amiltonkoxi/FMEAD-FPGA/vitis_platform/mb_edge_wrapper/microblaze_0/standalone_microblaze_0/bsp/microblaze_0/include/xparameters.h

#ifndef XPARAMETERS_H   /* prevent circular inclusions */
#define XPARAMETERS_H   /* by using protection macros */

/* Definitions for bus frequencies */
#define XPAR_CPU_M_AXI_DP_FREQ_HZ 100000000
/******************************************************************/

/* Canonical definitions for bus frequencies */
/******************************************************************/

#define XPAR_CPU_CORE_CLOCK_FREQ_HZ 100000000
#define XPAR_MICROBLAZE_CORE_CLOCK_FREQ_HZ 100000000

/******************************************************************/


/* Definitions for peripheral MICROBLAZE_0 */
#define XPAR_MICROBLAZE_0_ADDR_SIZE 32
#define XPAR_MICROBLAZE_0_ADDR_TAG_BITS 17
#define XPAR_MICROBLAZE_0_ALLOW_DCACHE_WR 1
#define XPAR_MICROBLAZE_0_ALLOW_ICACHE_WR 1
#define XPAR_MICROBLAZE_0_AREA_OPTIMIZED 0
#define XPAR_MICROBLAZE_0_ASYNC_INTERRUPT 1
#define XPAR_MICROBLAZE_0_ASYNC_WAKEUP 3
#define XPAR_MICROBLAZE_0_AVOID_PRIMITIVES 0
#define XPAR_MICROBLAZE_0_BASE_VECTORS 0x0000000000000000
#define XPAR_MICROBLAZE_0_BRANCH_TARGET_CACHE_SIZE 0
#define XPAR_MICROBLAZE_0_CACHE_BYTE_SIZE 8192
#define XPAR_MICROBLAZE_0_DADDR_SIZE 32
#define XPAR_MICROBLAZE_0_DATA_SIZE 32
#define XPAR_MICROBLAZE_0_DCACHE_ADDR_TAG 17
#define XPAR_MICROBLAZE_0_DCACHE_ALWAYS_USED 1
#define XPAR_MICROBLAZE_0_DCACHE_BASEADDR 0x00000000
#define XPAR_MICROBLAZE_0_DCACHE_BYTE_SIZE 8192
#define XPAR_MICROBLAZE_0_DCACHE_DATA_WIDTH 0
#define XPAR_MICROBLAZE_0_DCACHE_FORCE_TAG_LUTRAM 0
#define XPAR_MICROBLAZE_0_DCACHE_HIGHADDR 0x3FFFFFFF
#define XPAR_MICROBLAZE_0_DCACHE_LINE_LEN 4
#define XPAR_MICROBLAZE_0_DCACHE_USE_WRITEBACK 0
#define XPAR_MICROBLAZE_0_DCACHE_VICTIMS 0
#define XPAR_MICROBLAZE_0_DC_AXI_MON 0
#define XPAR_MICROBLAZE_0_DEBUG_COUNTER_WIDTH 32
#define XPAR_MICROBLAZE_0_DEBUG_ENABLED 1
#define XPAR_MICROBLAZE_0_DEBUG_EVENT_COUNTERS 5
#define XPAR_MICROBLAZE_0_DEBUG_EXTERNAL_TRACE 0
#define XPAR_MICROBLAZE_0_DEBUG_INTERFACE 0
#define XPAR_MICROBLAZE_0_DEBUG_LATENCY_COUNTERS 1
#define XPAR_MICROBLAZE_0_DEBUG_PROFILE_SIZE 0
#define XPAR_MICROBLAZE_0_DEBUG_TRACE_ASYNC_RESET 0
#define XPAR_MICROBLAZE_0_DEBUG_TRACE_SIZE 8192
#define XPAR_MICROBLAZE_0_DIV_ZERO_EXCEPTION 0
#define XPAR_MICROBLAZE_0_DP_AXI_MON 0
#define XPAR_MICROBLAZE_0_DYNAMIC_BUS_SIZING 0
#define XPAR_MICROBLAZE_0_D_AXI 1
#define XPAR_MICROBLAZE_0_D_LMB 1
#define XPAR_MICROBLAZE_0_D_LMB_MON 0
#define XPAR_MICROBLAZE_0_D_LMB_PROTOCOL 0
#define XPAR_MICROBLAZE_0_ECC_USE_CE_EXCEPTION 0
#define XPAR_MICROBLAZE_0_EDGE_IS_POSITIVE 1
#define XPAR_MICROBLAZE_0_ENABLE_DISCRETE_PORTS 0
#define XPAR_MICROBLAZE_0_ENDIANNESS 1
#define XPAR_MICROBLAZE_0_FAULT_TOLERANT 0
#define XPAR_MICROBLAZE_0_FPU_EXCEPTION 0
#define XPAR_MICROBLAZE_0_FREQ 100000000
#define XPAR_MICROBLAZE_0_FSL_EXCEPTION 0
#define XPAR_MICROBLAZE_0_FSL_LINKS 0
#define XPAR_MICROBLAZE_0_IADDR_SIZE 32
#define XPAR_MICROBLAZE_0_ICACHE_ALWAYS_USED 1
#define XPAR_MICROBLAZE_0_ICACHE_BASEADDR 0x00000000
#define XPAR_MICROBLAZE_0_ICACHE_DATA_WIDTH 0
#define XPAR_MICROBLAZE_0_ICACHE_FORCE_TAG_LUTRAM 0
#define XPAR_MICROBLAZE_0_ICACHE_HIGHADDR 0x3FFFFFFF
#define XPAR_MICROBLAZE_0_ICACHE_LINE_LEN 4
#define XPAR_MICROBLAZE_0_ICACHE_STREAMS 0
#define XPAR_MICROBLAZE_0_ICACHE_VICTIMS 0
#define XPAR_MICROBLAZE_0_IC_AXI_MON 0
#define XPAR_MICROBLAZE_0_ILL_OPCODE_EXCEPTION 0
#define XPAR_MICROBLAZE_0_IMPRECISE_EXCEPTIONS 0
#define XPAR_MICROBLAZE_0_INSTR_SIZE 32
#define XPAR_MICROBLAZE_0_INTERCONNECT 2
#define XPAR_MICROBLAZE_0_INTERRUPT_IS_EDGE 0
#define XPAR_MICROBLAZE_0_INTERRUPT_MON 0
#define XPAR_MICROBLAZE_0_IP_AXI_MON 0
#define XPAR_MICROBLAZE_0_I_AXI 0
#define XPAR_MICROBLAZE_0_I_LMB 1
#define XPAR_MICROBLAZE_0_I_LMB_MON 0
#define XPAR_MICROBLAZE_0_I_LMB_PROTOCOL 0
#define XPAR_MICROBLAZE_0_LMB_DATA_SIZE 32
#define XPAR_MICROBLAZE_0_LOCKSTEP_MASTER 0
#define XPAR_MICROBLAZE_0_LOCKSTEP_SELECT 0
#define XPAR_MICROBLAZE_0_LOCKSTEP_SLAVE 0
#define XPAR_MICROBLAZE_0_M0_AXIS_DATA_WIDTH 32
#define XPAR_MICROBLAZE_0_M0_AXIS_PROTOCOL GENERIC
#define XPAR_MICROBLAZE_0_M1_AXIS_DATA_WIDTH 32
#define XPAR_MICROBLAZE_0_M1_AXIS_PROTOCOL GENERIC
#define XPAR_MICROBLAZE_0_M2_AXIS_DATA_WIDTH 32
#define XPAR_MICROBLAZE_0_M2_AXIS_PROTOCOL GENERIC
#define XPAR_MICROBLAZE_0_M3_AXIS_DATA_WIDTH 32
#define XPAR_MICROBLAZE_0_M3_AXIS_PROTOCOL GENERIC
#define XPAR_MICROBLAZE_0_M4_AXIS_DATA_WIDTH 32
#define XPAR_MICROBLAZE_0_M4_AXIS_PROTOCOL GENERIC
#define XPAR_MICROBLAZE_0_M5_AXIS_DATA_WIDTH 32
#define XPAR_MICROBLAZE_0_M5_AXIS_PROTOCOL GENERIC
#define XPAR_MICROBLAZE_0_M6_AXIS_DATA_WIDTH 32
#define XPAR_MICROBLAZE_0_M6_AXIS_PROTOCOL GENERIC
#define XPAR_MICROBLAZE_0_M7_AXIS_DATA_WIDTH 32
#define XPAR_MICROBLAZE_0_M7_AXIS_PROTOCOL GENERIC
#define XPAR_MICROBLAZE_0_M8_AXIS_DATA_WIDTH 32
#define XPAR_MICROBLAZE_0_M8_AXIS_PROTOCOL GENERIC
#define XPAR_MICROBLAZE_0_M9_AXIS_DATA_WIDTH 32
#define XPAR_MICROBLAZE_0_M9_AXIS_PROTOCOL GENERIC
#define XPAR_MICROBLAZE_0_M10_AXIS_DATA_WIDTH 32
#define XPAR_MICROBLAZE_0_M10_AXIS_PROTOCOL GENERIC
#define XPAR_MICROBLAZE_0_M11_AXIS_DATA_WIDTH 32
#define XPAR_MICROBLAZE_0_M11_AXIS_PROTOCOL GENERIC
#define XPAR_MICROBLAZE_0_M12_AXIS_DATA_WIDTH 32
#define XPAR_MICROBLAZE_0_M12_AXIS_PROTOCOL GENERIC
#define XPAR_MICROBLAZE_0_M13_AXIS_DATA_WIDTH 32
#define XPAR_MICROBLAZE_0_M13_AXIS_PROTOCOL GENERIC
#define XPAR_MICROBLAZE_0_M14_AXIS_DATA_WIDTH 32
#define XPAR_MICROBLAZE_0_M14_AXIS_PROTOCOL GENERIC
#define XPAR_MICROBLAZE_0_M15_AXIS_DATA_WIDTH 32
#define XPAR_MICROBLAZE_0_M15_AXIS_PROTOCOL GENERIC
#define XPAR_MICROBLAZE_0_MMU_DTLB_SIZE 4
#define XPAR_MICROBLAZE_0_MMU_ITLB_SIZE 2
#define XPAR_MICROBLAZE_0_MMU_PRIVILEGED_INSTR 0
#define XPAR_MICROBLAZE_0_MMU_TLB_ACCESS 3
#define XPAR_MICROBLAZE_0_MMU_ZONES 16
#define XPAR_MICROBLAZE_0_M_AXI_DC_ADDR_WIDTH 32
#define XPAR_MICROBLAZE_0_M_AXI_DC_ARUSER_WIDTH 5
#define XPAR_MICROBLAZE_0_M_AXI_DC_AWUSER_WIDTH 5
#define XPAR_MICROBLAZE_0_M_AXI_DC_BUSER_WIDTH 1
#define XPAR_MICROBLAZE_0_M_AXI_DC_DATA_WIDTH 32
#define XPAR_MICROBLAZE_0_M_AXI_DC_EXCLUSIVE_ACCESS 0
#define XPAR_MICROBLAZE_0_M_AXI_DC_RUSER_WIDTH 1
#define XPAR_MICROBLAZE_0_M_AXI_DC_THREAD_ID_WIDTH 1
#define XPAR_MICROBLAZE_0_M_AXI_DC_USER_SIGNALS 0
#define XPAR_MICROBLAZE_0_M_AXI_DC_USER_VALUE 31
#define XPAR_MICROBLAZE_0_M_AXI_DC_WUSER_WIDTH 1
#define XPAR_MICROBLAZE_0_M_AXI_DP_ADDR_WIDTH 32
#define XPAR_MICROBLAZE_0_M_AXI_DP_DATA_WIDTH 32
#define XPAR_MICROBLAZE_0_M_AXI_DP_EXCLUSIVE_ACCESS 0
#define XPAR_MICROBLAZE_0_M_AXI_DP_THREAD_ID_WIDTH 1
#define XPAR_MICROBLAZE_0_M_AXI_D_BUS_EXCEPTION 0
#define XPAR_MICROBLAZE_0_M_AXI_IC_ADDR_WIDTH 32
#define XPAR_MICROBLAZE_0_M_AXI_IC_ARUSER_WIDTH 5
#define XPAR_MICROBLAZE_0_M_AXI_IC_AWUSER_WIDTH 5
#define XPAR_MICROBLAZE_0_M_AXI_IC_BUSER_WIDTH 1
#define XPAR_MICROBLAZE_0_M_AXI_IC_DATA_WIDTH 32
#define XPAR_MICROBLAZE_0_M_AXI_IC_RUSER_WIDTH 1
#define XPAR_MICROBLAZE_0_M_AXI_IC_THREAD_ID_WIDTH 1
#define XPAR_MICROBLAZE_0_M_AXI_IC_USER_SIGNALS 0
#define XPAR_MICROBLAZE_0_M_AXI_IC_USER_VALUE 31
#define XPAR_MICROBLAZE_0_M_AXI_IC_WUSER_WIDTH 1
#define XPAR_MICROBLAZE_0_M_AXI_IP_ADDR_WIDTH 32
#define XPAR_MICROBLAZE_0_M_AXI_IP_DATA_WIDTH 32
#define XPAR_MICROBLAZE_0_M_AXI_IP_THREAD_ID_WIDTH 1
#define XPAR_MICROBLAZE_0_M_AXI_I_BUS_EXCEPTION 0
#define XPAR_MICROBLAZE_0_NUMBER_OF_PC_BRK 1
#define XPAR_MICROBLAZE_0_NUMBER_OF_RD_ADDR_BRK 0
#define XPAR_MICROBLAZE_0_NUMBER_OF_WR_ADDR_BRK 0
#define XPAR_MICROBLAZE_0_NUM_SYNC_FF_CLK 2
#define XPAR_MICROBLAZE_0_NUM_SYNC_FF_CLK_DEBUG 2
#define XPAR_MICROBLAZE_0_NUM_SYNC_FF_CLK_IRQ 1
#define XPAR_MICROBLAZE_0_NUM_SYNC_FF_DBG_CLK 1
#define XPAR_MICROBLAZE_0_NUM_SYNC_FF_DBG_TRACE_CLK 2
#define XPAR_MICROBLAZE_0_OPCODE_0X0_ILLEGAL 0
#define XPAR_MICROBLAZE_0_OPTIMIZATION 0
#define XPAR_MICROBLAZE_0_PC_WIDTH 32
#define XPAR_MICROBLAZE_0_PIADDR_SIZE 32
#define XPAR_MICROBLAZE_0_PVR 0
#define XPAR_MICROBLAZE_0_PVR_USER1 0x00
#define XPAR_MICROBLAZE_0_PVR_USER2 0x00000000
#define XPAR_MICROBLAZE_0_RESET_MSR 0x00000000
#define XPAR_MICROBLAZE_0_RESET_MSR_BIP 0
#define XPAR_MICROBLAZE_0_RESET_MSR_DCE 0
#define XPAR_MICROBLAZE_0_RESET_MSR_EE 0
#define XPAR_MICROBLAZE_0_RESET_MSR_EIP 0
#define XPAR_MICROBLAZE_0_RESET_MSR_ICE 0
#define XPAR_MICROBLAZE_0_RESET_MSR_IE 0
#define XPAR_MICROBLAZE_0_S0_AXIS_DATA_WIDTH 32
#define XPAR_MICROBLAZE_0_S0_AXIS_PROTOCOL GENERIC
#define XPAR_MICROBLAZE_0_S1_AXIS_DATA_WIDTH 32
#define XPAR_MICROBLAZE_0_S1_AXIS_PROTOCOL GENERIC
#define XPAR_MICROBLAZE_0_S2_AXIS_DATA_WIDTH 32
#define XPAR_MICROBLAZE_0_S2_AXIS_PROTOCOL GENERIC
#define XPAR_MICROBLAZE_0_S3_AXIS_DATA_WIDTH 32
#define XPAR_MICROBLAZE_0_S3_AXIS_PROTOCOL GENERIC
#define XPAR_MICROBLAZE_0_S4_AXIS_DATA_WIDTH 32
#define XPAR_MICROBLAZE_0_S4_AXIS_PROTOCOL GENERIC
#define XPAR_MICROBLAZE_0_S5_AXIS_DATA_WIDTH 32
#define XPAR_MICROBLAZE_0_S5_AXIS_PROTOCOL GENERIC
#define XPAR_MICROBLAZE_0_S6_AXIS_DATA_WIDTH 32
#define XPAR_MICROBLAZE_0_S6_AXIS_PROTOCOL GENERIC
#define XPAR_MICROBLAZE_0_S7_AXIS_DATA_WIDTH 32
#define XPAR_MICROBLAZE_0_S7_AXIS_PROTOCOL GENERIC
#define XPAR_MICROBLAZE_0_S8_AXIS_DATA_WIDTH 32
#define XPAR_MICROBLAZE_0_S8_AXIS_PROTOCOL GENERIC
#define XPAR_MICROBLAZE_0_S9_AXIS_DATA_WIDTH 32
#define XPAR_MICROBLAZE_0_S9_AXIS_PROTOCOL GENERIC
#define XPAR_MICROBLAZE_0_S10_AXIS_DATA_WIDTH 32
#define XPAR_MICROBLAZE_0_S10_AXIS_PROTOCOL GENERIC
#define XPAR_MICROBLAZE_0_S11_AXIS_DATA_WIDTH 32
#define XPAR_MICROBLAZE_0_S11_AXIS_PROTOCOL GENERIC
#define XPAR_MICROBLAZE_0_S12_AXIS_DATA_WIDTH 32
#define XPAR_MICROBLAZE_0_S12_AXIS_PROTOCOL GENERIC
#define XPAR_MICROBLAZE_0_S13_AXIS_DATA_WIDTH 32
#define XPAR_MICROBLAZE_0_S13_AXIS_PROTOCOL GENERIC
#define XPAR_MICROBLAZE_0_S14_AXIS_DATA_WIDTH 32
#define XPAR_MICROBLAZE_0_S14_AXIS_PROTOCOL GENERIC
#define XPAR_MICROBLAZE_0_S15_AXIS_DATA_WIDTH 32
#define XPAR_MICROBLAZE_0_S15_AXIS_PROTOCOL GENERIC
#define XPAR_MICROBLAZE_0_SCO 0
#define XPAR_MICROBLAZE_0_TEMPORAL_DEPTH 0
#define XPAR_MICROBLAZE_0_TRACE 0
#define XPAR_MICROBLAZE_0_UNALIGNED_EXCEPTIONS 0
#define XPAR_MICROBLAZE_0_USE_BARREL 0
#define XPAR_MICROBLAZE_0_USE_BRANCH_TARGET_CACHE 0
#define XPAR_MICROBLAZE_0_USE_CONFIG_RESET 0
#define XPAR_MICROBLAZE_0_USE_DCACHE 0
#define XPAR_MICROBLAZE_0_USE_DIV 0
#define XPAR_MICROBLAZE_0_USE_EXTENDED_FSL_INSTR 0
#define XPAR_MICROBLAZE_0_USE_EXT_BRK 0
#define XPAR_MICROBLAZE_0_USE_EXT_NM_BRK 0
#define XPAR_MICROBLAZE_0_USE_FPU 0
#define XPAR_MICROBLAZE_0_USE_HW_MUL 0
#define XPAR_MICROBLAZE_0_USE_ICACHE 0
#define XPAR_MICROBLAZE_0_USE_INTERRUPT 0
#define XPAR_MICROBLAZE_0_USE_MMU 0
#define XPAR_MICROBLAZE_0_USE_MSR_INSTR 0
#define XPAR_MICROBLAZE_0_USE_NON_SECURE 0
#define XPAR_MICROBLAZE_0_USE_PCMP_INSTR 0
#define XPAR_MICROBLAZE_0_USE_REORDER_INSTR 1
#define XPAR_MICROBLAZE_0_USE_STACK_PROTECTION 0
#define XPAR_MICROBLAZE_0_COMPONENT_NAME mb_edge_microblaze_0_0
#define XPAR_MICROBLAZE_0_EDK_IPTYPE PROCESSOR
#define XPAR_MICROBLAZE_0_EDK_SPECIAL microblaze
#define XPAR_MICROBLAZE_0_G_TEMPLATE_LIST 0
#define XPAR_MICROBLAZE_0_G_USE_EXCEPTIONS 0

/******************************************************************/

#define XPAR_CPU_ID 0
#define XPAR_MICROBLAZE_ID 0
#define XPAR_MICROBLAZE_ADDR_SIZE 32
#define XPAR_MICROBLAZE_ADDR_TAG_BITS 17
#define XPAR_MICROBLAZE_ALLOW_DCACHE_WR 1
#define XPAR_MICROBLAZE_ALLOW_ICACHE_WR 1
#define XPAR_MICROBLAZE_AREA_OPTIMIZED 0
#define XPAR_MICROBLAZE_ASYNC_INTERRUPT 1
#define XPAR_MICROBLAZE_ASYNC_WAKEUP 3
#define XPAR_MICROBLAZE_AVOID_PRIMITIVES 0
#define XPAR_MICROBLAZE_BASE_VECTORS 0x0000000000000000
#define XPAR_MICROBLAZE_BRANCH_TARGET_CACHE_SIZE 0
#define XPAR_MICROBLAZE_CACHE_BYTE_SIZE 8192
#define XPAR_MICROBLAZE_DADDR_SIZE 32
#define XPAR_MICROBLAZE_DATA_SIZE 32
#define XPAR_MICROBLAZE_DCACHE_ADDR_TAG 17
#define XPAR_MICROBLAZE_DCACHE_ALWAYS_USED 1
#define XPAR_MICROBLAZE_DCACHE_BASEADDR 0x00000000
#define XPAR_MICROBLAZE_DCACHE_BYTE_SIZE 8192
#define XPAR_MICROBLAZE_DCACHE_DATA_WIDTH 0
#define XPAR_MICROBLAZE_DCACHE_FORCE_TAG_LUTRAM 0
#define XPAR_MICROBLAZE_DCACHE_HIGHADDR 0x3FFFFFFF
#define XPAR_MICROBLAZE_DCACHE_LINE_LEN 4
#define XPAR_MICROBLAZE_DCACHE_USE_WRITEBACK 0
#define XPAR_MICROBLAZE_DCACHE_VICTIMS 0
#define XPAR_MICROBLAZE_DC_AXI_MON 0
#define XPAR_MICROBLAZE_DEBUG_COUNTER_WIDTH 32
#define XPAR_MICROBLAZE_DEBUG_ENABLED 1
#define XPAR_MICROBLAZE_DEBUG_EVENT_COUNTERS 5
#define XPAR_MICROBLAZE_DEBUG_EXTERNAL_TRACE 0
#define XPAR_MICROBLAZE_DEBUG_INTERFACE 0
#define XPAR_MICROBLAZE_DEBUG_LATENCY_COUNTERS 1
#define XPAR_MICROBLAZE_DEBUG_PROFILE_SIZE 0
#define XPAR_MICROBLAZE_DEBUG_TRACE_ASYNC_RESET 0
#define XPAR_MICROBLAZE_DEBUG_TRACE_SIZE 8192
#define XPAR_MICROBLAZE_DIV_ZERO_EXCEPTION 0
#define XPAR_MICROBLAZE_DP_AXI_MON 0
#define XPAR_MICROBLAZE_DYNAMIC_BUS_SIZING 0
#define XPAR_MICROBLAZE_D_AXI 1
#define XPAR_MICROBLAZE_D_LMB 1
#define XPAR_MICROBLAZE_D_LMB_MON 0
#define XPAR_MICROBLAZE_D_LMB_PROTOCOL 0
#define XPAR_MICROBLAZE_ECC_USE_CE_EXCEPTION 0
#define XPAR_MICROBLAZE_EDGE_IS_POSITIVE 1
#define XPAR_MICROBLAZE_ENABLE_DISCRETE_PORTS 0
#define XPAR_MICROBLAZE_ENDIANNESS 1
#define XPAR_MICROBLAZE_FAULT_TOLERANT 0
#define XPAR_MICROBLAZE_FPU_EXCEPTION 0
#define XPAR_MICROBLAZE_FREQ 100000000
#define XPAR_MICROBLAZE_FSL_EXCEPTION 0
#define XPAR_MICROBLAZE_FSL_LINKS 0
#define XPAR_MICROBLAZE_IADDR_SIZE 32
#define XPAR_MICROBLAZE_ICACHE_ALWAYS_USED 1
#define XPAR_MICROBLAZE_ICACHE_BASEADDR 0x00000000
#define XPAR_MICROBLAZE_ICACHE_DATA_WIDTH 0
#define XPAR_MICROBLAZE_ICACHE_FORCE_TAG_LUTRAM 0
#define XPAR_MICROBLAZE_ICACHE_HIGHADDR 0x3FFFFFFF
#define XPAR_MICROBLAZE_ICACHE_LINE_LEN 4
#define XPAR_MICROBLAZE_ICACHE_STREAMS 0
#define XPAR_MICROBLAZE_ICACHE_VICTIMS 0
#define XPAR_MICROBLAZE_IC_AXI_MON 0
#define XPAR_MICROBLAZE_ILL_OPCODE_EXCEPTION 0
#define XPAR_MICROBLAZE_IMPRECISE_EXCEPTIONS 0
#define XPAR_MICROBLAZE_INSTR_SIZE 32
#define XPAR_MICROBLAZE_INTERCONNECT 2
#define XPAR_MICROBLAZE_INTERRUPT_IS_EDGE 0
#define XPAR_MICROBLAZE_INTERRUPT_MON 0
#define XPAR_MICROBLAZE_IP_AXI_MON 0
#define XPAR_MICROBLAZE_I_AXI 0
#define XPAR_MICROBLAZE_I_LMB 1
#define XPAR_MICROBLAZE_I_LMB_MON 0
#define XPAR_MICROBLAZE_I_LMB_PROTOCOL 0
#define XPAR_MICROBLAZE_LMB_DATA_SIZE 32
#define XPAR_MICROBLAZE_LOCKSTEP_MASTER 0
#define XPAR_MICROBLAZE_LOCKSTEP_SELECT 0
#define XPAR_MICROBLAZE_LOCKSTEP_SLAVE 0
#define XPAR_MICROBLAZE_M0_AXIS_DATA_WIDTH 32
#define XPAR_MICROBLAZE_M0_AXIS_PROTOCOL GENERIC
#define XPAR_MICROBLAZE_M1_AXIS_DATA_WIDTH 32
#define XPAR_MICROBLAZE_M1_AXIS_PROTOCOL GENERIC
#define XPAR_MICROBLAZE_M2_AXIS_DATA_WIDTH 32
#define XPAR_MICROBLAZE_M2_AXIS_PROTOCOL GENERIC
#define XPAR_MICROBLAZE_M3_AXIS_DATA_WIDTH 32
#define XPAR_MICROBLAZE_M3_AXIS_PROTOCOL GENERIC
#define XPAR_MICROBLAZE_M4_AXIS_DATA_WIDTH 32
#define XPAR_MICROBLAZE_M4_AXIS_PROTOCOL GENERIC
#define XPAR_MICROBLAZE_M5_AXIS_DATA_WIDTH 32
#define XPAR_MICROBLAZE_M5_AXIS_PROTOCOL GENERIC
#define XPAR_MICROBLAZE_M6_AXIS_DATA_WIDTH 32
#define XPAR_MICROBLAZE_M6_AXIS_PROTOCOL GENERIC
#define XPAR_MICROBLAZE_M7_AXIS_DATA_WIDTH 32
#define XPAR_MICROBLAZE_M7_AXIS_PROTOCOL GENERIC
#define XPAR_MICROBLAZE_M8_AXIS_DATA_WIDTH 32
#define XPAR_MICROBLAZE_M8_AXIS_PROTOCOL GENERIC
#define XPAR_MICROBLAZE_M9_AXIS_DATA_WIDTH 32
#define XPAR_MICROBLAZE_M9_AXIS_PROTOCOL GENERIC
#define XPAR_MICROBLAZE_M10_AXIS_DATA_WIDTH 32
#define XPAR_MICROBLAZE_M10_AXIS_PROTOCOL GENERIC
#define XPAR_MICROBLAZE_M11_AXIS_DATA_WIDTH 32
#define XPAR_MICROBLAZE_M11_AXIS_PROTOCOL GENERIC
#define XPAR_MICROBLAZE_M12_AXIS_DATA_WIDTH 32
#define XPAR_MICROBLAZE_M12_AXIS_PROTOCOL GENERIC
#define XPAR_MICROBLAZE_M13_AXIS_DATA_WIDTH 32
#define XPAR_MICROBLAZE_M13_AXIS_PROTOCOL GENERIC
#define XPAR_MICROBLAZE_M14_AXIS_DATA_WIDTH 32
#define XPAR_MICROBLAZE_M14_AXIS_PROTOCOL GENERIC
#define XPAR_MICROBLAZE_M15_AXIS_DATA_WIDTH 32
#define XPAR_MICROBLAZE_M15_AXIS_PROTOCOL GENERIC
#define XPAR_MICROBLAZE_MMU_DTLB_SIZE 4
#define XPAR_MICROBLAZE_MMU_ITLB_SIZE 2
#define XPAR_MICROBLAZE_MMU_PRIVILEGED_INSTR 0
#define XPAR_MICROBLAZE_MMU_TLB_ACCESS 3
#define XPAR_MICROBLAZE_MMU_ZONES 16
#define XPAR_MICROBLAZE_M_AXI_DC_ADDR_WIDTH 32
#define XPAR_MICROBLAZE_M_AXI_DC_ARUSER_WIDTH 5
#define XPAR_MICROBLAZE_M_AXI_DC_AWUSER_WIDTH 5
#define XPAR_MICROBLAZE_M_AXI_DC_BUSER_WIDTH 1
#define XPAR_MICROBLAZE_M_AXI_DC_DATA_WIDTH 32
#define XPAR_MICROBLAZE_M_AXI_DC_EXCLUSIVE_ACCESS 0
#define XPAR_MICROBLAZE_M_AXI_DC_RUSER_WIDTH 1
#define XPAR_MICROBLAZE_M_AXI_DC_THREAD_ID_WIDTH 1
#define XPAR_MICROBLAZE_M_AXI_DC_USER_SIGNALS 0
#define XPAR_MICROBLAZE_M_AXI_DC_USER_VALUE 31
#define XPAR_MICROBLAZE_M_AXI_DC_WUSER_WIDTH 1
#define XPAR_MICROBLAZE_M_AXI_DP_ADDR_WIDTH 32
#define XPAR_MICROBLAZE_M_AXI_DP_DATA_WIDTH 32
#define XPAR_MICROBLAZE_M_AXI_DP_EXCLUSIVE_ACCESS 0
#define XPAR_MICROBLAZE_M_AXI_DP_THREAD_ID_WIDTH 1
#define XPAR_MICROBLAZE_M_AXI_D_BUS_EXCEPTION 0
#define XPAR_MICROBLAZE_M_AXI_IC_ADDR_WIDTH 32
#define XPAR_MICROBLAZE_M_AXI_IC_ARUSER_WIDTH 5
#define XPAR_MICROBLAZE_M_AXI_IC_AWUSER_WIDTH 5
#define XPAR_MICROBLAZE_M_AXI_IC_BUSER_WIDTH 1
#define XPAR_MICROBLAZE_M_AXI_IC_DATA_WIDTH 32
#define XPAR_MICROBLAZE_M_AXI_IC_RUSER_WIDTH 1
#define XPAR_MICROBLAZE_M_AXI_IC_THREAD_ID_WIDTH 1
#define XPAR_MICROBLAZE_M_AXI_IC_USER_SIGNALS 0
#define XPAR_MICROBLAZE_M_AXI_IC_USER_VALUE 31
#define XPAR_MICROBLAZE_M_AXI_IC_WUSER_WIDTH 1
#define XPAR_MICROBLAZE_M_AXI_IP_ADDR_WIDTH 32
#define XPAR_MICROBLAZE_M_AXI_IP_DATA_WIDTH 32
#define XPAR_MICROBLAZE_M_AXI_IP_THREAD_ID_WIDTH 1
#define XPAR_MICROBLAZE_M_AXI_I_BUS_EXCEPTION 0
#define XPAR_MICROBLAZE_NUMBER_OF_PC_BRK 1
#define XPAR_MICROBLAZE_NUMBER_OF_RD_ADDR_BRK 0
#define XPAR_MICROBLAZE_NUMBER_OF_WR_ADDR_BRK 0
#define XPAR_MICROBLAZE_NUM_SYNC_FF_CLK 2
#define XPAR_MICROBLAZE_NUM_SYNC_FF_CLK_DEBUG 2
#define XPAR_MICROBLAZE_NUM_SYNC_FF_CLK_IRQ 1
#define XPAR_MICROBLAZE_NUM_SYNC_FF_DBG_CLK 1
#define XPAR_MICROBLAZE_NUM_SYNC_FF_DBG_TRACE_CLK 2
#define XPAR_MICROBLAZE_OPCODE_0X0_ILLEGAL 0
#define XPAR_MICROBLAZE_OPTIMIZATION 0
#define XPAR_MICROBLAZE_PC_WIDTH 32
#define XPAR_MICROBLAZE_PIADDR_SIZE 32
#define XPAR_MICROBLAZE_PVR 0
#define XPAR_MICROBLAZE_PVR_USER1 0x00
#define XPAR_MICROBLAZE_PVR_USER2 0x00000000
#define XPAR_MICROBLAZE_RESET_MSR 0x00000000
#define XPAR_MICROBLAZE_RESET_MSR_BIP 0
#define XPAR_MICROBLAZE_RESET_MSR_DCE 0
#define XPAR_MICROBLAZE_RESET_MSR_EE 0
#define XPAR_MICROBLAZE_RESET_MSR_EIP 0
#define XPAR_MICROBLAZE_RESET_MSR_ICE 0
#define XPAR_MICROBLAZE_RESET_MSR_IE 0
#define XPAR_MICROBLAZE_S0_AXIS_DATA_WIDTH 32
#define XPAR_MICROBLAZE_S0_AXIS_PROTOCOL GENERIC
#define XPAR_MICROBLAZE_S1_AXIS_DATA_WIDTH 32
#define XPAR_MICROBLAZE_S1_AXIS_PROTOCOL GENERIC
#define XPAR_MICROBLAZE_S2_AXIS_DATA_WIDTH 32
#define XPAR_MICROBLAZE_S2_AXIS_PROTOCOL GENERIC
#define XPAR_MICROBLAZE_S3_AXIS_DATA_WIDTH 32
#define XPAR_MICROBLAZE_S3_AXIS_PROTOCOL GENERIC
#define XPAR_MICROBLAZE_S4_AXIS_DATA_WIDTH 32
#define XPAR_MICROBLAZE_S4_AXIS_PROTOCOL GENERIC
#define XPAR_MICROBLAZE_S5_AXIS_DATA_WIDTH 32
#define XPAR_MICROBLAZE_S5_AXIS_PROTOCOL GENERIC
#define XPAR_MICROBLAZE_S6_AXIS_DATA_WIDTH 32
#define XPAR_MICROBLAZE_S6_AXIS_PROTOCOL GENERIC
#define XPAR_MICROBLAZE_S7_AXIS_DATA_WIDTH 32
#define XPAR_MICROBLAZE_S7_AXIS_PROTOCOL GENERIC
#define XPAR_MICROBLAZE_S8_AXIS_DATA_WIDTH 32
#define XPAR_MICROBLAZE_S8_AXIS_PROTOCOL GENERIC
#define XPAR_MICROBLAZE_S9_AXIS_DATA_WIDTH 32
#define XPAR_MICROBLAZE_S9_AXIS_PROTOCOL GENERIC
#define XPAR_MICROBLAZE_S10_AXIS_DATA_WIDTH 32
#define XPAR_MICROBLAZE_S10_AXIS_PROTOCOL GENERIC
#define XPAR_MICROBLAZE_S11_AXIS_DATA_WIDTH 32
#define XPAR_MICROBLAZE_S11_AXIS_PROTOCOL GENERIC
#define XPAR_MICROBLAZE_S12_AXIS_DATA_WIDTH 32
#define XPAR_MICROBLAZE_S12_AXIS_PROTOCOL GENERIC
#define XPAR_MICROBLAZE_S13_AXIS_DATA_WIDTH 32
#define XPAR_MICROBLAZE_S13_AXIS_PROTOCOL GENERIC
#define XPAR_MICROBLAZE_S14_AXIS_DATA_WIDTH 32
#define XPAR_MICROBLAZE_S14_AXIS_PROTOCOL GENERIC
#define XPAR_MICROBLAZE_S15_AXIS_DATA_WIDTH 32
#define XPAR_MICROBLAZE_S15_AXIS_PROTOCOL GENERIC
#define XPAR_MICROBLAZE_SCO 0
#define XPAR_MICROBLAZE_TEMPORAL_DEPTH 0
#define XPAR_MICROBLAZE_TRACE 0
#define XPAR_MICROBLAZE_UNALIGNED_EXCEPTIONS 0
#define XPAR_MICROBLAZE_USE_BARREL 0
#define XPAR_MICROBLAZE_USE_BRANCH_TARGET_CACHE 0
#define XPAR_MICROBLAZE_USE_CONFIG_RESET 0
#define XPAR_MICROBLAZE_USE_DCACHE 0
#define XPAR_MICROBLAZE_USE_DIV 0
#define XPAR_MICROBLAZE_USE_EXTENDED_FSL_INSTR 0
#define XPAR_MICROBLAZE_USE_EXT_BRK 0
#define XPAR_MICROBLAZE_USE_EXT_NM_BRK 0
#define XPAR_MICROBLAZE_USE_FPU 0
#define XPAR_MICROBLAZE_USE_HW_MUL 0
#define XPAR_MICROBLAZE_USE_ICACHE 0
#define XPAR_MICROBLAZE_USE_INTERRUPT 0
#define XPAR_MICROBLAZE_USE_MMU 0
#define XPAR_MICROBLAZE_USE_MSR_INSTR 0
#define XPAR_MICROBLAZE_USE_NON_SECURE 0
#define XPAR_MICROBLAZE_USE_PCMP_INSTR 0
#define XPAR_MICROBLAZE_USE_REORDER_INSTR 1
#define XPAR_MICROBLAZE_USE_STACK_PROTECTION 0
#define XPAR_MICROBLAZE_COMPONENT_NAME mb_edge_microblaze_0_0
#define XPAR_MICROBLAZE_EDK_IPTYPE PROCESSOR
#define XPAR_MICROBLAZE_EDK_SPECIAL microblaze
#define XPAR_MICROBLAZE_G_TEMPLATE_LIST 0
#define XPAR_MICROBLAZE_G_USE_EXCEPTIONS 0

/******************************************************************/

#define STDIN_BASEADDRESS 0x40600000
#define STDOUT_BASEADDRESS 0x40600000

/******************************************************************/

/* Platform specific definitions */
#define PLATFORM_MB
 
/* Definitions for sleep timer configuration */
#define XSLEEP_TIMER_IS_DEFAULT_TIMER
 
 
/******************************************************************/
/* Definitions for driver PMODBT2 */
#define XPAR_PMODBT2_NUM_INSTANCES 1

/* Definitions for peripheral PMODBT2_0 */
#define XPAR_PMODBT2_0_DEVICE_ID 0
#define XPAR_PMODBT2_0_AXI_LITE_UART_BASEADDR 0x00022000
#define XPAR_PMODBT2_0_AXI_LITE_UART_HIGHADDR 0x00023FFF
#define XPAR_PMODBT2_0_AXI_LITE_GPIO_BASEADDR 0x00020000
#define XPAR_PMODBT2_0_AXI_LITE_GPIO_HIGHADDR 0x00020FFF


/******************************************************************/

/* Definitions for driver PMODESP32 */
#define XPAR_PMODESP32_NUM_INSTANCES 1

/* Definitions for peripheral PMODESP32_0 */
#define XPAR_PMODESP32_0_DEVICE_ID 0
#define XPAR_PMODESP32_0_AXI_LITE_UART_BASEADDR 0x44A30000
#define XPAR_PMODESP32_0_AXI_LITE_UART_HIGHADDR 0x44A3FFFF
#define XPAR_PMODESP32_0_AXI_LITE_GPIO_BASEADDR 0x44A20000
#define XPAR_PMODESP32_0_AXI_LITE_GPIO_HIGHADDR 0x44A2FFFF


/******************************************************************/

/* Definitions for driver PMODOLEDRGB */
#define XPAR_PMODOLEDRGB_NUM_INSTANCES 1

/* Definitions for peripheral PMODOLEDRGB_0 */
#define XPAR_PMODOLEDRGB_0_DEVICE_ID 0
#define XPAR_PMODOLEDRGB_0_AXI_LITE_GPIO_BASEADDR 0x44A10000
#define XPAR_PMODOLEDRGB_0_AXI_LITE_GPIO_HIGHADDR 0x44A1FFFF
#define XPAR_PMODOLEDRGB_0_AXI_LITE_SPI_BASEADDR 0x44A40000
#define XPAR_PMODOLEDRGB_0_AXI_LITE_SPI_HIGHADDR 0x44A4FFFF


/******************************************************************/

/* Definitions for driver BRAM */
#define XPAR_XBRAM_NUM_INSTANCES 2U

/* Definitions for peripheral MICROBLAZE_0_LOCAL_MEMORY_DLMB_BRAM_IF_CNTLR */
#define XPAR_MICROBLAZE_0_LOCAL_MEMORY_DLMB_BRAM_IF_CNTLR_DEVICE_ID 0U
#define XPAR_MICROBLAZE_0_LOCAL_MEMORY_DLMB_BRAM_IF_CNTLR_DATA_WIDTH 32U
#define XPAR_MICROBLAZE_0_LOCAL_MEMORY_DLMB_BRAM_IF_CNTLR_ECC 0U
#define XPAR_MICROBLAZE_0_LOCAL_MEMORY_DLMB_BRAM_IF_CNTLR_FAULT_INJECT 0U
#define XPAR_MICROBLAZE_0_LOCAL_MEMORY_DLMB_BRAM_IF_CNTLR_CE_FAILING_REGISTERS 0U
#define XPAR_MICROBLAZE_0_LOCAL_MEMORY_DLMB_BRAM_IF_CNTLR_UE_FAILING_REGISTERS 0U
#define XPAR_MICROBLAZE_0_LOCAL_MEMORY_DLMB_BRAM_IF_CNTLR_ECC_STATUS_REGISTERS 0U
#define XPAR_MICROBLAZE_0_LOCAL_MEMORY_DLMB_BRAM_IF_CNTLR_CE_COUNTER_WIDTH 0U
#define XPAR_MICROBLAZE_0_LOCAL_MEMORY_DLMB_BRAM_IF_CNTLR_ECC_ONOFF_REGISTER 0U
#define XPAR_MICROBLAZE_0_LOCAL_MEMORY_DLMB_BRAM_IF_CNTLR_ECC_ONOFF_RESET_VALUE 1U
#define XPAR_MICROBLAZE_0_LOCAL_MEMORY_DLMB_BRAM_IF_CNTLR_WRITE_ACCESS 2U
#define XPAR_MICROBLAZE_0_LOCAL_MEMORY_DLMB_BRAM_IF_CNTLR_BASEADDR 0x00000000U
#define XPAR_MICROBLAZE_0_LOCAL_MEMORY_DLMB_BRAM_IF_CNTLR_HIGHADDR 0x0001FFFFU
#define XPAR_MICROBLAZE_0_LOCAL_MEMORY_DLMB_BRAM_IF_CNTLR_S_AXI_CTRL_BASEADDR 0xFFFFFFFFU  
#define XPAR_MICROBLAZE_0_LOCAL_MEMORY_DLMB_BRAM_IF_CNTLR_S_AXI_CTRL_HIGHADDR 0xFFFFFFFFU  


/* Definitions for peripheral MICROBLAZE_0_LOCAL_MEMORY_ILMB_BRAM_IF_CNTLR */
#define XPAR_MICROBLAZE_0_LOCAL_MEMORY_ILMB_BRAM_IF_CNTLR_DEVICE_ID 1U
#define XPAR_MICROBLAZE_0_LOCAL_MEMORY_ILMB_BRAM_IF_CNTLR_DATA_WIDTH 32U
#define XPAR_MICROBLAZE_0_LOCAL_MEMORY_ILMB_BRAM_IF_CNTLR_ECC 0U
#define XPAR_MICROBLAZE_0_LOCAL_MEMORY_ILMB_BRAM_IF_CNTLR_FAULT_INJECT 0U
#define XPAR_MICROBLAZE_0_LOCAL_MEMORY_ILMB_BRAM_IF_CNTLR_CE_FAILING_REGISTERS 0U
#define XPAR_MICROBLAZE_0_LOCAL_MEMORY_ILMB_BRAM_IF_CNTLR_UE_FAILING_REGISTERS 0U
#define XPAR_MICROBLAZE_0_LOCAL_MEMORY_ILMB_BRAM_IF_CNTLR_ECC_STATUS_REGISTERS 0U
#define XPAR_MICROBLAZE_0_LOCAL_MEMORY_ILMB_BRAM_IF_CNTLR_CE_COUNTER_WIDTH 0U
#define XPAR_MICROBLAZE_0_LOCAL_MEMORY_ILMB_BRAM_IF_CNTLR_ECC_ONOFF_REGISTER 0U
#define XPAR_MICROBLAZE_0_LOCAL_MEMORY_ILMB_BRAM_IF_CNTLR_ECC_ONOFF_RESET_VALUE 1U
#define XPAR_MICROBLAZE_0_LOCAL_MEMORY_ILMB_BRAM_IF_CNTLR_WRITE_ACCESS 2U
#define XPAR_MICROBLAZE_0_LOCAL_MEMORY_ILMB_BRAM_IF_CNTLR_BASEADDR 0x00000000U
#define XPAR_MICROBLAZE_0_LOCAL_MEMORY_ILMB_BRAM_IF_CNTLR_HIGHADDR 0x0001FFFFU
#define XPAR_MICROBLAZE_0_LOCAL_MEMORY_ILMB_BRAM_IF_CNTLR_S_AXI_CTRL_BASEADDR 0xFFFFFFFFU  
#define XPAR_MICROBLAZE_0_LOCAL_MEMORY_ILMB_BRAM_IF_CNTLR_S_AXI_CTRL_HIGHADDR 0xFFFFFFFFU  


/******************************************************************/

/* Canonical definitions for peripheral MICROBLAZE_0_LOCAL_MEMORY_DLMB_BRAM_IF_CNTLR */
#define XPAR_BRAM_0_DEVICE_ID XPAR_MICROBLAZE_0_LOCAL_MEMORY_DLMB_BRAM_IF_CNTLR_DEVICE_ID
#define XPAR_BRAM_0_DATA_WIDTH 32U
#define XPAR_BRAM_0_ECC 0U
#define XPAR_BRAM_0_FAULT_INJECT 0U
#define XPAR_BRAM_0_CE_FAILING_REGISTERS 0U
#define XPAR_BRAM_0_UE_FAILING_REGISTERS 0U
#define XPAR_BRAM_0_ECC_STATUS_REGISTERS 0U
#define XPAR_BRAM_0_CE_COUNTER_WIDTH 0U
#define XPAR_BRAM_0_ECC_ONOFF_REGISTER 0U
#define XPAR_BRAM_0_ECC_ONOFF_RESET_VALUE 1U
#define XPAR_BRAM_0_WRITE_ACCESS 2U
#define XPAR_BRAM_0_BASEADDR 0x00000000U
#define XPAR_BRAM_0_HIGHADDR 0x0001FFFFU
#define XPAR_BRAM_0_CTRL_BASEADDR 0xFFFFFFFFU  
#define XPAR_BRAM_0_CTRL_HIGHADDR 0xFFFFFFFEU  
#define XPAR_DLMB_0_CNTLR_BASEADDR 0x00000000
#define XPAR_DLMB_0_CNTLR_HIGHADDR 0x0001FFFF
#define XPAR_DLMB_CNTLR_BASEADDR XPAR_DLMB_0_CNTLR_BASEADDR
#define XPAR_DLMB_CNTLR_HIGHADDR XPAR_DLMB_0_CNTLR_HIGHADDR

/* Canonical definitions for peripheral MICROBLAZE_0_LOCAL_MEMORY_ILMB_BRAM_IF_CNTLR */
#define XPAR_BRAM_1_DEVICE_ID XPAR_MICROBLAZE_0_LOCAL_MEMORY_ILMB_BRAM_IF_CNTLR_DEVICE_ID
#define XPAR_BRAM_1_DATA_WIDTH 32U
#define XPAR_BRAM_1_ECC 0U
#define XPAR_BRAM_1_FAULT_INJECT 0U
#define XPAR_BRAM_1_CE_FAILING_REGISTERS 0U
#define XPAR_BRAM_1_UE_FAILING_REGISTERS 0U
#define XPAR_BRAM_1_ECC_STATUS_REGISTERS 0U
#define XPAR_BRAM_1_CE_COUNTER_WIDTH 0U
#define XPAR_BRAM_1_ECC_ONOFF_REGISTER 0U
#define XPAR_BRAM_1_ECC_ONOFF_RESET_VALUE 1U
#define XPAR_BRAM_1_WRITE_ACCESS 2U
#define XPAR_BRAM_1_BASEADDR 0x00000000U
#define XPAR_BRAM_1_HIGHADDR 0x0001FFFFU
#define XPAR_BRAM_1_CTRL_BASEADDR 0xFFFFFFFFU  
#define XPAR_BRAM_1_CTRL_HIGHADDR 0xFFFFFFFEU  
#define XPAR_ILMB_0_CNTLR_BASEADDR 0x00000000
#define XPAR_ILMB_0_CNTLR_HIGHADDR 0x0001FFFF
#define XPAR_ILMB_CNTLR_BASEADDR XPAR_ILMB_0_CNTLR_BASEADDR
#define XPAR_ILMB_CNTLR_HIGHADDR XPAR_ILMB_0_CNTLR_HIGHADDR


/******************************************************************/

/* Definitions for driver GPIO */
#define XPAR_XGPIO_NUM_INSTANCES 6

/* Definitions for peripheral AXI_GPIO_BUTTONS */
#define XPAR_AXI_GPIO_BUTTONS_BASEADDR 0x40000000
#define XPAR_AXI_GPIO_BUTTONS_HIGHADDR 0x4000FFFF
#define XPAR_AXI_GPIO_BUTTONS_DEVICE_ID 0
#define XPAR_AXI_GPIO_BUTTONS_INTERRUPT_PRESENT 0
#define XPAR_AXI_GPIO_BUTTONS_IS_DUAL 0


/* Definitions for peripheral AXI_GPIO_LEDS */
#define XPAR_AXI_GPIO_LEDS_BASEADDR 0x40010000
#define XPAR_AXI_GPIO_LEDS_HIGHADDR 0x4001FFFF
#define XPAR_AXI_GPIO_LEDS_DEVICE_ID 1
#define XPAR_AXI_GPIO_LEDS_INTERRUPT_PRESENT 0
#define XPAR_AXI_GPIO_LEDS_IS_DUAL 0


/* Definitions for peripheral AXI_GPIO_SWITCHES */
#define XPAR_AXI_GPIO_SWITCHES_BASEADDR 0x40020000
#define XPAR_AXI_GPIO_SWITCHES_HIGHADDR 0x4002FFFF
#define XPAR_AXI_GPIO_SWITCHES_DEVICE_ID 2
#define XPAR_AXI_GPIO_SWITCHES_INTERRUPT_PRESENT 0
#define XPAR_AXI_GPIO_SWITCHES_IS_DUAL 1


/* Definitions for peripheral AXI_GPIO_7SEG_AN */
#define XPAR_AXI_GPIO_7SEG_AN_BASEADDR 0x40030000
#define XPAR_AXI_GPIO_7SEG_AN_HIGHADDR 0x4003FFFF
#define XPAR_AXI_GPIO_7SEG_AN_DEVICE_ID 3
#define XPAR_AXI_GPIO_7SEG_AN_INTERRUPT_PRESENT 0
#define XPAR_AXI_GPIO_7SEG_AN_IS_DUAL 0


/* Definitions for peripheral AXI_GPIO_7SEG_SEG */
#define XPAR_AXI_GPIO_7SEG_SEG_BASEADDR 0x40040000
#define XPAR_AXI_GPIO_7SEG_SEG_HIGHADDR 0x4004FFFF
#define XPAR_AXI_GPIO_7SEG_SEG_DEVICE_ID 4
#define XPAR_AXI_GPIO_7SEG_SEG_INTERRUPT_PRESENT 0
#define XPAR_AXI_GPIO_7SEG_SEG_IS_DUAL 0


/* Definitions for peripheral AXI_GPIO_PCM */
#define XPAR_AXI_GPIO_PCM_BASEADDR 0x40050000
#define XPAR_AXI_GPIO_PCM_HIGHADDR 0x4005FFFF
#define XPAR_AXI_GPIO_PCM_DEVICE_ID 5
#define XPAR_AXI_GPIO_PCM_INTERRUPT_PRESENT 0
#define XPAR_AXI_GPIO_PCM_IS_DUAL 1


/******************************************************************/

/* Canonical definitions for peripheral AXI_GPIO_BUTTONS */
#define XPAR_GPIO_0_BASEADDR 0x40000000
#define XPAR_GPIO_0_HIGHADDR 0x4000FFFF
#define XPAR_GPIO_0_DEVICE_ID XPAR_AXI_GPIO_BUTTONS_DEVICE_ID
#define XPAR_GPIO_0_INTERRUPT_PRESENT 0
#define XPAR_GPIO_0_IS_DUAL 0

/* Canonical definitions for peripheral AXI_GPIO_LEDS */
#define XPAR_GPIO_1_BASEADDR 0x40010000
#define XPAR_GPIO_1_HIGHADDR 0x4001FFFF
#define XPAR_GPIO_1_DEVICE_ID XPAR_AXI_GPIO_LEDS_DEVICE_ID
#define XPAR_GPIO_1_INTERRUPT_PRESENT 0
#define XPAR_GPIO_1_IS_DUAL 0

/* Canonical definitions for peripheral AXI_GPIO_SWITCHES */
#define XPAR_GPIO_2_BASEADDR 0x40020000
#define XPAR_GPIO_2_HIGHADDR 0x4002FFFF
#define XPAR_GPIO_2_DEVICE_ID XPAR_AXI_GPIO_SWITCHES_DEVICE_ID
#define XPAR_GPIO_2_INTERRUPT_PRESENT 0
#define XPAR_GPIO_2_IS_DUAL 1

/* Canonical definitions for peripheral AXI_GPIO_7SEG_AN */
#define XPAR_GPIO_3_BASEADDR 0x40030000
#define XPAR_GPIO_3_HIGHADDR 0x4003FFFF
#define XPAR_GPIO_3_DEVICE_ID XPAR_AXI_GPIO_7SEG_AN_DEVICE_ID
#define XPAR_GPIO_3_INTERRUPT_PRESENT 0
#define XPAR_GPIO_3_IS_DUAL 0

/* Canonical definitions for peripheral AXI_GPIO_7SEG_SEG */
#define XPAR_GPIO_4_BASEADDR 0x40040000
#define XPAR_GPIO_4_HIGHADDR 0x4004FFFF
#define XPAR_GPIO_4_DEVICE_ID XPAR_AXI_GPIO_7SEG_SEG_DEVICE_ID
#define XPAR_GPIO_4_INTERRUPT_PRESENT 0
#define XPAR_GPIO_4_IS_DUAL 0

/* Canonical definitions for peripheral AXI_GPIO_PCM */
#define XPAR_GPIO_5_BASEADDR 0x40050000
#define XPAR_GPIO_5_HIGHADDR 0x4005FFFF
#define XPAR_GPIO_5_DEVICE_ID XPAR_AXI_GPIO_PCM_DEVICE_ID
#define XPAR_GPIO_5_INTERRUPT_PRESENT 0
#define XPAR_GPIO_5_IS_DUAL 1


/******************************************************************/

/* Definitions for driver IIC */
#define XPAR_XIIC_NUM_INSTANCES 1

/* Definitions for peripheral AXI_IIC_BME280 */
#define XPAR_AXI_IIC_BME280_DEVICE_ID 0
#define XPAR_AXI_IIC_BME280_BASEADDR 0x40800000
#define XPAR_AXI_IIC_BME280_HIGHADDR 0x4080FFFF
#define XPAR_AXI_IIC_BME280_TEN_BIT_ADR 0
#define XPAR_AXI_IIC_BME280_GPO_WIDTH 1


/******************************************************************/

/* Canonical definitions for peripheral AXI_IIC_BME280 */
#define XPAR_IIC_0_DEVICE_ID XPAR_AXI_IIC_BME280_DEVICE_ID
#define XPAR_IIC_0_BASEADDR 0x40800000
#define XPAR_IIC_0_HIGHADDR 0x4080FFFF
#define XPAR_IIC_0_TEN_BIT_ADR 0
#define XPAR_IIC_0_GPO_WIDTH 1


/******************************************************************/

/* Definitions for driver SPI */
#define XPAR_XSPI_NUM_INSTANCES 1U

/* Definitions for peripheral AXI_QUAD_SPI_ADXL362 */
#define XPAR_AXI_QUAD_SPI_ADXL362_DEVICE_ID 0U
#define XPAR_AXI_QUAD_SPI_ADXL362_BASEADDR 0x44A00000U
#define XPAR_AXI_QUAD_SPI_ADXL362_HIGHADDR 0x44A0FFFFU
#define XPAR_AXI_QUAD_SPI_ADXL362_FIFO_EXIST 1U
#define XPAR_AXI_QUAD_SPI_ADXL362_FIFO_DEPTH 16U
#define XPAR_AXI_QUAD_SPI_ADXL362_SPI_SLAVE_ONLY 0U
#define XPAR_AXI_QUAD_SPI_ADXL362_NUM_SS_BITS 1U
#define XPAR_AXI_QUAD_SPI_ADXL362_NUM_TRANSFER_BITS 8U
#define XPAR_AXI_QUAD_SPI_ADXL362_SPI_MODE 0U
#define XPAR_AXI_QUAD_SPI_ADXL362_TYPE_OF_AXI4_INTERFACE 0U
#define XPAR_AXI_QUAD_SPI_ADXL362_AXI4_BASEADDR 0U
#define XPAR_AXI_QUAD_SPI_ADXL362_AXI4_HIGHADDR 0U
#define XPAR_AXI_QUAD_SPI_ADXL362_XIP_MODE 0U

/* Canonical definitions for peripheral AXI_QUAD_SPI_ADXL362 */
#define XPAR_SPI_0_DEVICE_ID 0U
#define XPAR_SPI_0_BASEADDR 0x44A00000U
#define XPAR_SPI_0_HIGHADDR 0x44A0FFFFU
#define XPAR_SPI_0_FIFO_EXIST 1U
#define XPAR_SPI_0_FIFO_DEPTH 16U
#define XPAR_SPI_0_SPI_SLAVE_ONLY 0U
#define XPAR_SPI_0_NUM_SS_BITS 1U
#define XPAR_SPI_0_NUM_TRANSFER_BITS 8U
#define XPAR_SPI_0_SPI_MODE 0U
#define XPAR_SPI_0_TYPE_OF_AXI4_INTERFACE 0U
#define XPAR_SPI_0_AXI4_BASEADDR 0U
#define XPAR_SPI_0_AXI4_HIGHADDR 0U
#define XPAR_SPI_0_XIP_MODE 0U
#define XPAR_SPI_0_USE_STARTUP 0U



/******************************************************************/

/* Definitions for driver SYSMON */
#define XPAR_XSYSMON_NUM_INSTANCES 1U

/* Definitions for peripheral XADC_WIZ_0 */
#define XPAR_XADC_WIZ_0_IP_TYPE 0U
#define XPAR_XADC_WIZ_0_DEVICE_ID 0U
#define XPAR_XADC_WIZ_0_BASEADDR 0x44A50000U
#define XPAR_XADC_WIZ_0_HIGHADDR 0x44A5FFFFU
#define XPAR_XADC_WIZ_0_INCLUDE_INTR 1U


/******************************************************************/

/* Canonical definitions for peripheral XADC_WIZ_0 */
#define XPAR_SYSMON_0_IP_TYPE 0U
#define XPAR_SYSMON_0_DEVICE_ID XPAR_XADC_WIZ_0_DEVICE_ID
#define XPAR_SYSMON_0_BASEADDR 0x44A50000U
#define XPAR_SYSMON_0_HIGHADDR 0x44A5FFFFU
#define XPAR_SYSMON_0_INCLUDE_INTR 1U


/******************************************************************/

/* Definitions for driver UARTLITE */
#define XPAR_XUARTLITE_NUM_INSTANCES 1U

/* Definitions for peripheral AXI_UARTLITE_0 */
#define XPAR_AXI_UARTLITE_0_DEVICE_ID 0U
#define XPAR_AXI_UARTLITE_0_BASEADDR 0x40600000U
#define XPAR_AXI_UARTLITE_0_HIGHADDR 0x4060FFFFU
#define XPAR_AXI_UARTLITE_0_BAUDRATE 9600U
#define XPAR_AXI_UARTLITE_0_USE_PARITY 0U
#define XPAR_AXI_UARTLITE_0_ODD_PARITY 0U
#define XPAR_AXI_UARTLITE_0_DATA_BITS 8U

/* Canonical definitions for peripheral AXI_UARTLITE_0 */
#define XPAR_UARTLITE_0_DEVICE_ID 0U
#define XPAR_UARTLITE_0_BASEADDR 0x40600000U
#define XPAR_UARTLITE_0_HIGHADDR 0x4060FFFFU
#define XPAR_UARTLITE_0_BAUDRATE 9600U
#define XPAR_UARTLITE_0_USE_PARITY 0U
#define XPAR_UARTLITE_0_ODD_PARITY 0U
#define XPAR_UARTLITE_0_DATA_BITS 8U


/******************************************************************/
#endif  /* end of protection macro */
